particle-iot/e-series-evaluation-board/README.md

# e-series-evaluation-board
Hardware repository for the E series evaluation board
