particle-iot/e-series-evaluation-board/images/e0-dev-description-v003.png

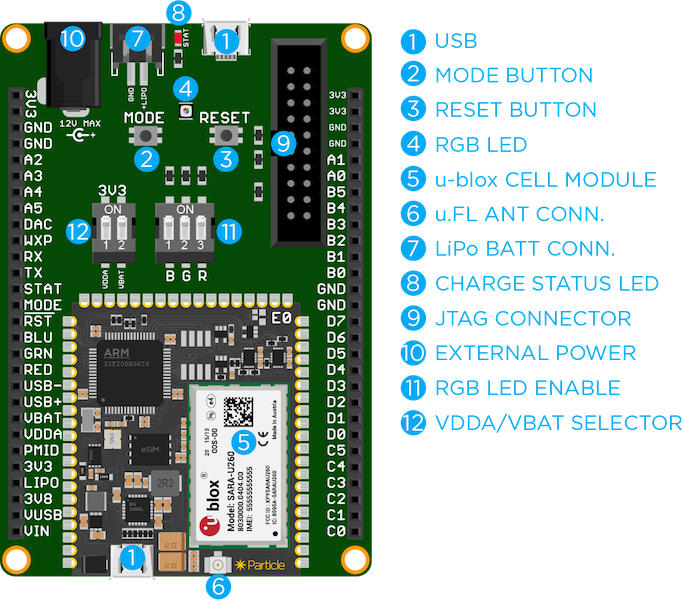
images/e0-dev-description-v003.png
