particle-iot/e-series-evaluation-board/bom/e0-dev-bom.xlsx

IDENTIFIER | DESCRIPTION | VALUE | V | A | W | TOL | PACKAGE ID | DESIGNATOR | QTY | MANUFACTURER | MANUFACTURER P/N | NOTES
BUTTON | SWITCH TACTILE SPST-NO 0.05A 12V | MOMENTARY-SWITCH-SPST-SMD-5.2MM | 12V | 0.05 |  |  | SMD 5.2MM | S1, S2 | 2 | Kingtek | TS4415-250GF | SAME OR EQUIVALENT
CAPACITOR | CAPACITOR | 10uF X5R LOW ESR | 25V |  |  | 10% | 805 | C1, C2, C3, C4, C5 | 5 | PANASONIC |  | DO NOT POPULATE
CAPACITOR | SMD ELECTROLYTIC CAPACITOR | 100uF | 25V |  |  | 10% |  | C6, C7 | 2 | PANASONIC |  | DO NOT POPULATE
CONNECTOR | LIPO BATTERY CONNECTOR |  |  |  |  |  | JST-2-SMD | JP1 | 1 | KAWEEI | CW2001-02T1-H01-D
CONNECTOR | MICRO USB CONNECTOR |  |  |  |  |  |  | X1, X2 | 2 | KAWEEI | CMCUSB-5BFM14X-01-X
CONNECTOR | SMA TO UFL ADAPTOR |  |  |  |  |  | THROUGH HOLE SMA TO UFL | X3 | 1 | KAWEEI | P1163-0140R | DO NOT POPULATE
CONNECTOR | CONNECTOR_GROVE | GROVE CONNECTOR |  |  |  |  | GROVE 4 PIN THROUGH HOLE | CONN1, CONN2 | 2 | KAWEEI | CW-A2008-04 | SAME OR EQUIVALENT
CONNECTOR | 26X2 FEMALE HEADER, 0.1" PITCH | 26X2 FEMALE HEADER, 0.1" PITCH |  |  |  |  | 0.1" PITCH 26X2 | J3 | 1 | KAWEEI | CS25402-52G-S85-A
CONNECTOR | DC BARREL JACK | POWER_JACKSLT |  |  |  |  | POWER_JACK_SLOT | J1 | 1 | KAWEEI | TDC-005B-20
LED | LED | RED LED |  |  |  |  | 603 | LED1 | 1 | EVERLIGHT | 19-217/R6C-AL1M2VY/3T
LED | RGB-LED-CLMVB-FKARGB | RGB LED |  |  |  |  | 4-PLCC (3.2 mm x 2.8mm) | U$6 | 1 | CREE | CLMVB-FKA-CFHEHLCBB7A363
RESISTOR | RESISTOR | 10K |  |  |  | 5% | 603 | R5, R6, R7 | 3 | Uniohm | RS-03K103JT
RESISTOR | RESISTOR | 1K |  |  |  | 5% | 603 | R1, R2, R3, R4 | 4 | Unihom | RS-03K102JT
SLIDE SWITCH | SWITCH SLIDE DIP SPST 100MA 20V | SLIDE SWITCH |  |  |  |  |  | S4 | 1 | Kingtek | DSIC0TSGET | SAME OR EQUIVALENT
