particle-iot/e-series-evaluation-board/eagle/e0-dev-v006/e0-dev-v006.brd

## EAGLE design eagle/e0-dev-v006/e0-dev-v006.brd (2021-02-23)

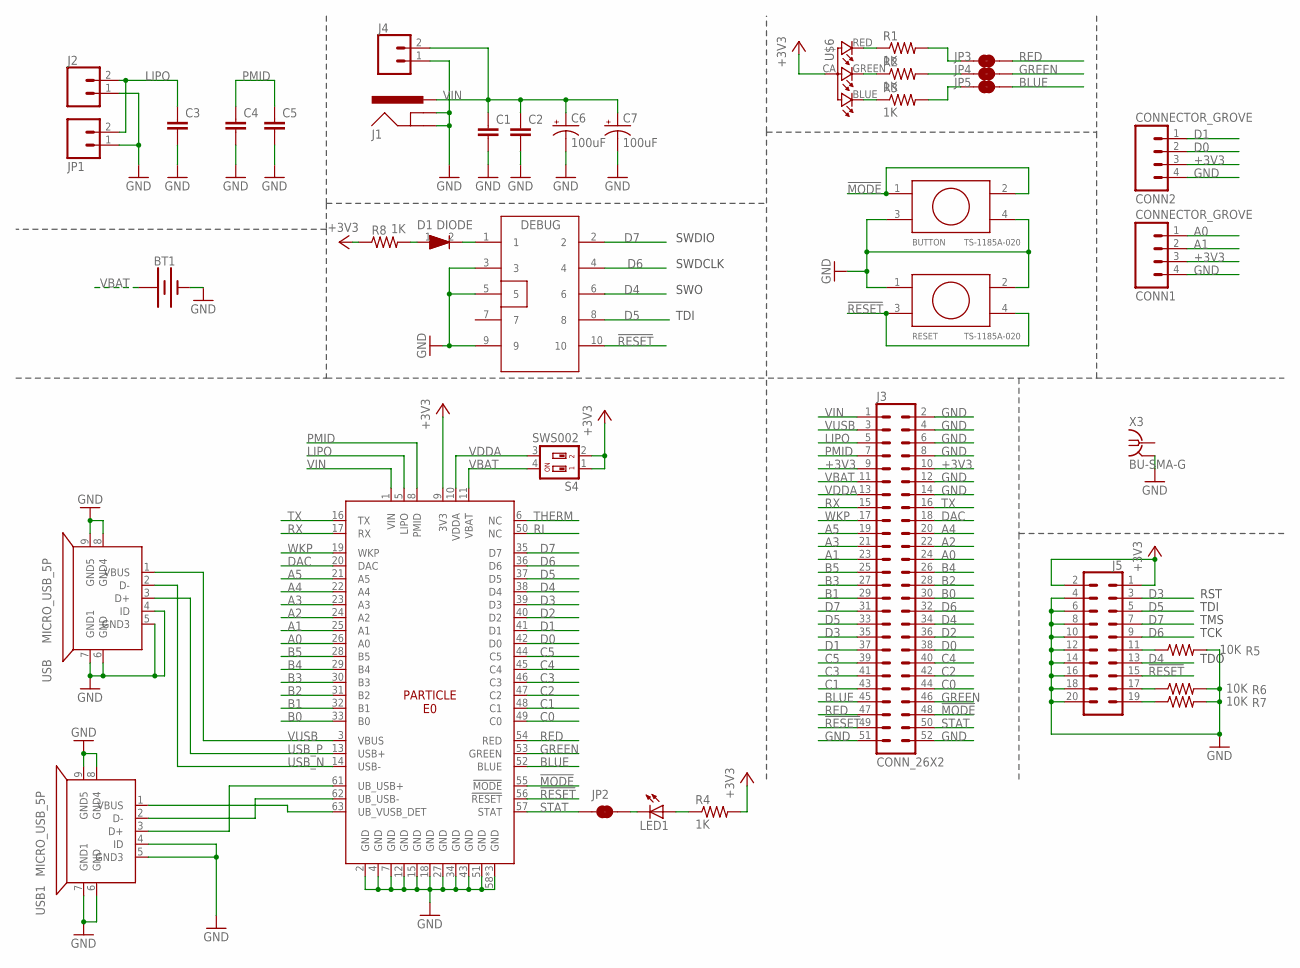
[picture p2: schematic e0-dev-v006.sch]

Parts:
BT1: BATTERY-20MM_SMD; BATTCON_20MM
BUTTON: TS-1185A-020
C1, C2, C3, C4, C5: C-EUC0805; C0805
C6, C7: 100uF; PANASONIC_D
CONN1, CONN2: CONNECTOR_GROVE; CONNCTOR_GROVE
D1: DIODE; SOD-323
DEBUG: CON5X2; CON5X2_1.27
J1: POWER_JACKSLT; POWER_JACK_SLOT
J2, J4: CONN_021X02_NO_SILK; 1X02_NO_SILK
J3: CONN_26X2; 2X26
J5: CONN_10X2NOSILK; 2X10_NOSILK
JP1: M02-JST-2MM-SMT; JST-2-SMD@1
JP2, JP3, JP4, JP5: JUMPER-SMT_2_NC_TRACE_NO-SILK; SMT-JUMPER_2_NC_TRACE_NO-SILK
LED1: LED0603; LED-0603
R1, R2, R3, R4, R8: 1K; R0603
R5, R6, R7: 10K; R0603
RESET: TS-1185A-020
S4: SWS002; SMS-002
U1: E0_V005; E0
U$6: RGB-LED-CLMVB-FKARGB; PLCC4-2MM-RGB
USB, USB1: MICRO_USB_5P; MICRO_USB
X3: BU-SMA-G

Connections:
!MODE: BUTTON.1, BUTTON.2, J3.48, U1.55 (!MODE)
!RESET: DEBUG.10, J3.49, J5.15, RESET.3, RESET.4, U1.56 (!RESET)
+3V3: CONN1.3, CONN2.3, J3.9, J3.10, J5.1, J5.2, R4.2, R8.1, S4.1, S4.2, U1.9 (3V3), U$6.CA (1)
A0: CONN1.1, J3.24, U1.26 (A0)
A1: CONN1.2, J3.23, U1.25 (A1)
A2: J3.22, U1.24 (A2)
A3: J3.21, U1.23 (A3)
A4: J3.20, U1.22 (A4)
A5: J3.19, U1.21 (A5)
B0: J3.30, U1.33 (B0)
B1: J3.29, U1.32 (B1)
B2: J3.28, U1.31 (B2)
B3: J3.27, U1.30 (B3)
B4: J3.26, U1.29 (B4)
B5: J3.25, U1.28 (B5)
BLUE: J3.45, JP5.2, U1.52 (BLUE)
C0: J3.44, U1.49 (C0)
C1: J3.43, U1.48 (C1)
C2: J3.42, U1.47 (C2)
C3: J3.41, U1.46 (C3)
C4: J3.40, U1.45 (C4)
C5: J3.39, U1.44 (C5)
D0: CONN2.2, J3.38, U1.42 (D0)
D1: CONN2.1, J3.37, U1.41 (D1)
D2: J3.36, U1.40 (D2)
D3: J3.35, J5.3, U1.39 (D3)
D4: DEBUG.6, J3.34, J5.13, U1.38 (D4)
D5: DEBUG.8, J3.33, J5.5, U1.37 (D5)
D6: DEBUG.4, J3.32, J5.9, U1.36 (D6)
D7: DEBUG.2, J3.31, J5.7, U1.35 (D7)
DAC: J3.18, U1.20 (DAC)
GND: BT1.2 (-), BUTTON.3, BUTTON.4, C1.2, C2.2, C3.2, C4.2, C5.2, C6.-, C7.-, CONN1.4, CONN2.4, DEBUG.3, DEBUG.5, DEBUG.9, J1.GND@1 (GNDBREAK), J1.GND@2 (GND), J2.1, J3.2, J3.4, J3.6, J3.8, J3.12, J3.14, J3.51, J3.52, J4.1, J5.4, J5.6, J5.8, J5.10, J5.12, J5.14, J5.16, J5.18, J5.20, JP1.1 (2), R5.2, R6.2, R7.2, RESET.1, RESET.2, U1.2 (GND), U1.4 (GND), U1.7 (GND), U1.12 (GND), U1.15 (GND), U1.18 (GND), U1.27 (GND), U1.34 (GND), U1.43 (GND), U1.51 (GND), U1.58 (GND), U1.59 (GND), U1.60 (GND), USB.4 (ID), USB.5 (GND3), USB.6 (GND), USB.7 (GND1), USB.8 (GND4), USB.9 (GND5), USB1.4 (ID), USB1.5 (GND3), USB1.6 (GND), USB1.7 (GND1), USB1.8 (GND4), USB1.9 (GND5), X3.2, X3.3 (2), X3.4 (2), X3.5 (2)
GREEN: J3.46, JP4.2, U1.53 (GREEN)
LIPO: C3.1, J2.2, J3.5, JP1.2 (1), U1.5 (LIPO)
unnamed: R1.1, U$6.RED (4)
unnamed: R2.1, U$6.GREEN (3)
unnamed: R3.1, U$6.BLUE (2)
unnamed: U1.63 (UB_VUSB_DET), USB1.1 (VBUS)
unnamed: JP4.1, R2.2
unnamed: JP3.1, R1.2
unnamed: JP5.1, R3.2
unnamed: LED1.A, R4.1
unnamed: J5.11, R5.1
unnamed: J5.17, R6.1
unnamed: J5.19, R7.1
unnamed: JP2.2, LED1.C
unnamed: D1.1, R8.2
unnamed: D1.2, DEBUG.1
PMID: C4.1, C5.1, J3.7, U1.8 (PMID)
RED: J3.47, JP3.2, U1.54 (RED)
RI: U1.50 (NC)
RX: J3.15, U1.17 (RX)
STAT: J3.50, JP2.1, U1.57 (STAT)
THERM: U1.6 (NC)
TX: J3.16, U1.16 (TX)
UB_USB_N: U1.62 (UB_USB-), USB1.2 (D-)
UB_USB_P: U1.61 (UB_USB+), USB1.3 (D+)
USB_N: U1.14 (USB-), USB.2 (D-)
USB_P: U1.13 (USB+), USB.3 (D+)
VBAT: BT1.1 (+), J3.11, S4.4, U1.11 (VBAT)
VDDA: J3.13, S4.3, U1.10 (VDDA)
VIN: C1.1, C2.1, C6.+, C7.+, J1.PWR, J3.1, J4.2, U1.1 (VIN)
VUSB: J3.3, U1.3 (VBUS), USB.1 (VBUS)
WKP: J3.17, U1.19 (WKP)

Notes on the sheet:
TMS
TCK
TDI
TDO
RST
SWO
SWDCLK
SWDIO

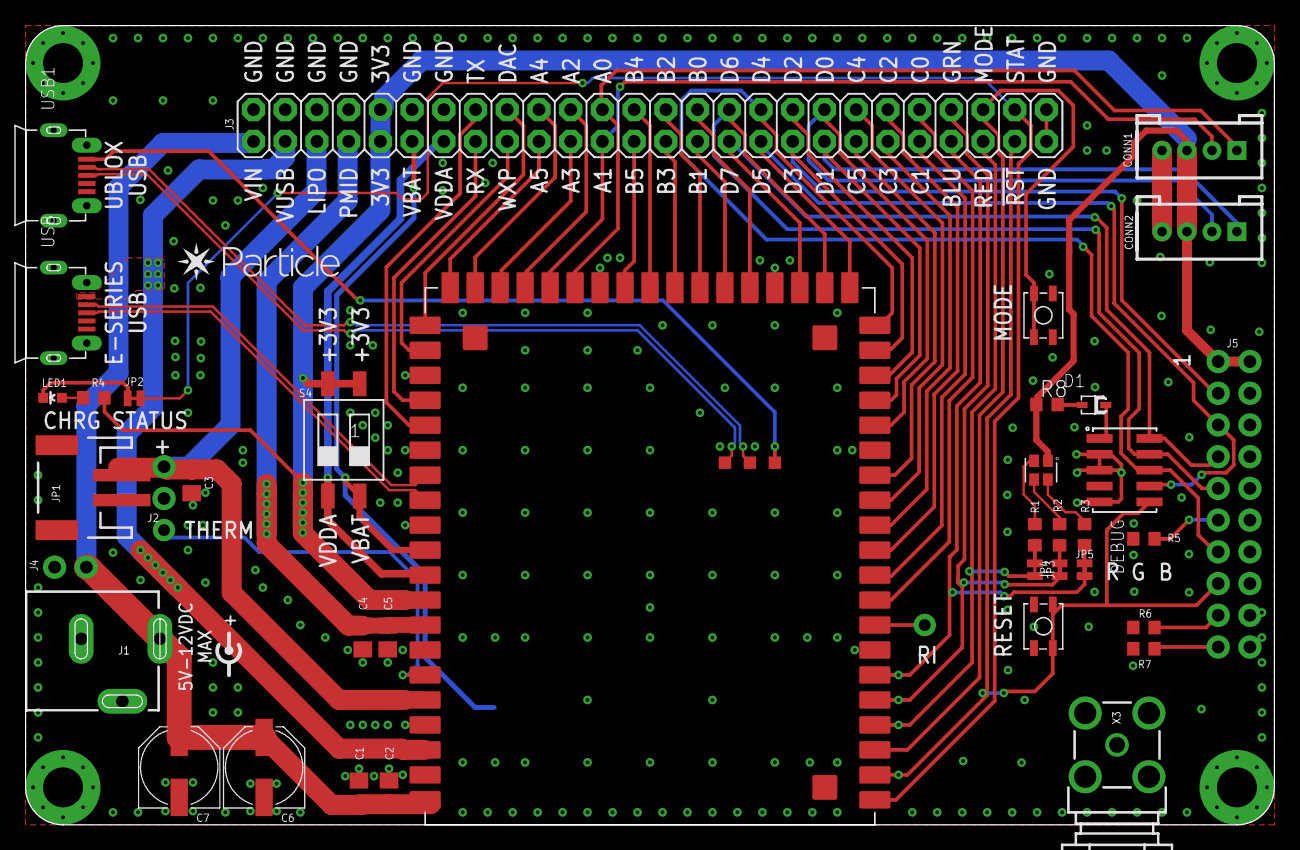
[picture p3: board e0-dev-v006.brd from above]

Board: 4 copper layers, 100.0 x 64.0 mm, 39 parts (1 on the bottom side), 62 nets.
