particle-iot/e-series-evaluation-board/images/e0-dev-setup-v003.png

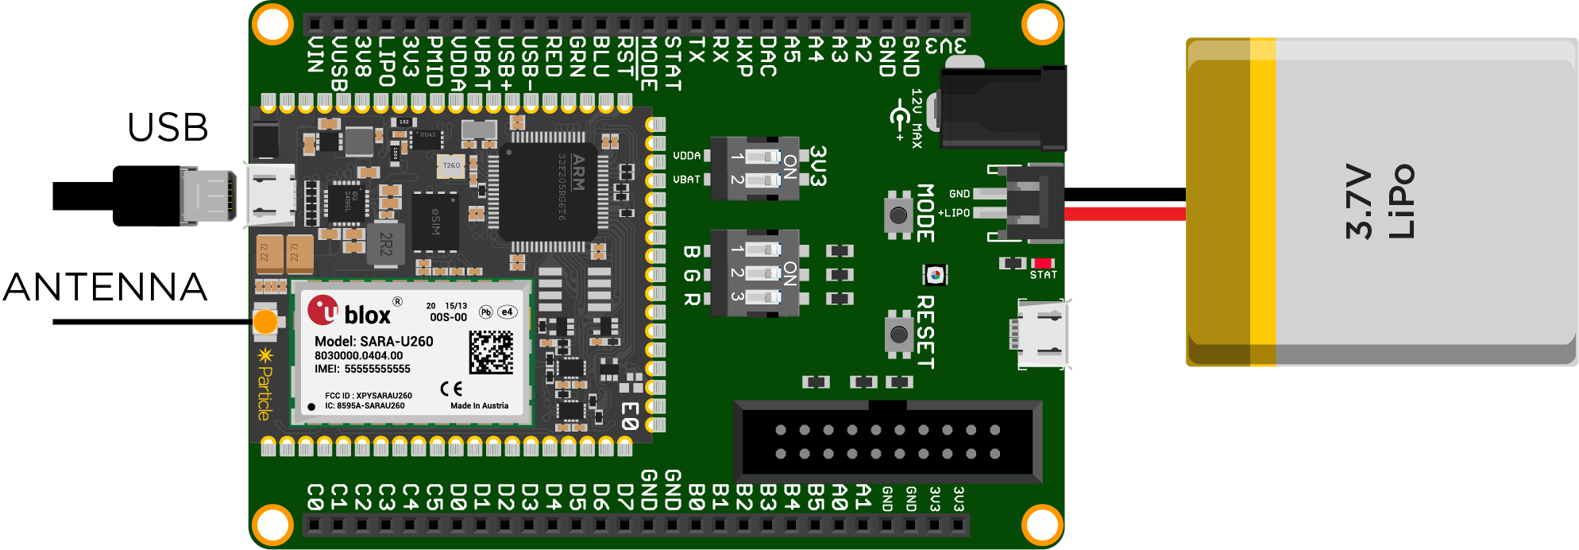
images/e0-dev-setup-v003.png
