particle-iot/e-series-evaluation-board/(commit log)

2018-01-30 Added bom and gerber files
    [e0-dev-bom.xlsx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]
2021-02-23 Add eval board v006
    [e0-dev-v006.GBL, e0-dev-v006.GBO, e0-dev-v006.GBP, e0-dev-v006.GBS, e0-dev-v006.GTL, e0-dev-v006.GTO, e0-dev-v006.GTP, e0-dev-v006.GTS]
